VoltaicEngineering/Solar-Panel-Brackets/README.md

# Solar-Panel-Brackets
Bracket designs to mount Voltaic solar panels to a pole

We fabricate these panels and sell them to our customers, but if you would like to modify the design or fabricate locally, you are free to do so.
