VoltaicEngineering/Solar-Panel-Brackets/Large Panel Bracket Rev 3 BENT STEP.step

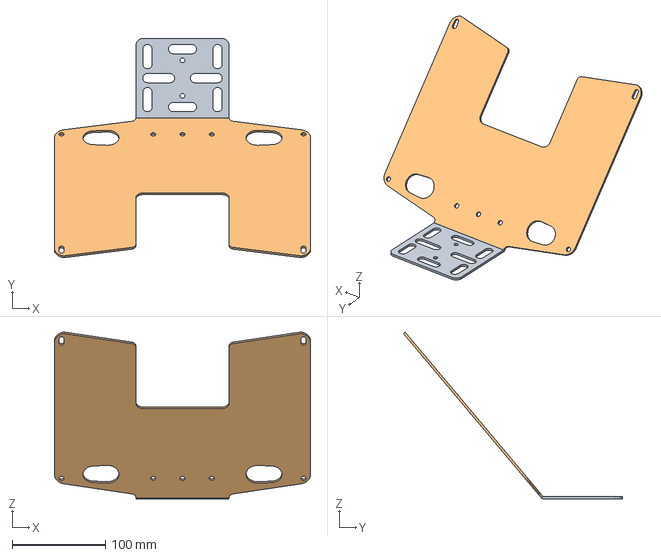
[picture p1: CAD file, 2018-04-16]
Large Panel Bracket Rev 3 BENT STEP.step
274.0 x 234.7 x 178.6 mm
Top Mounting
Panel Frame
