VoltaicEngineering/Solar-Panel-Brackets/Small Bracket Rev 4 BENT STEP.step

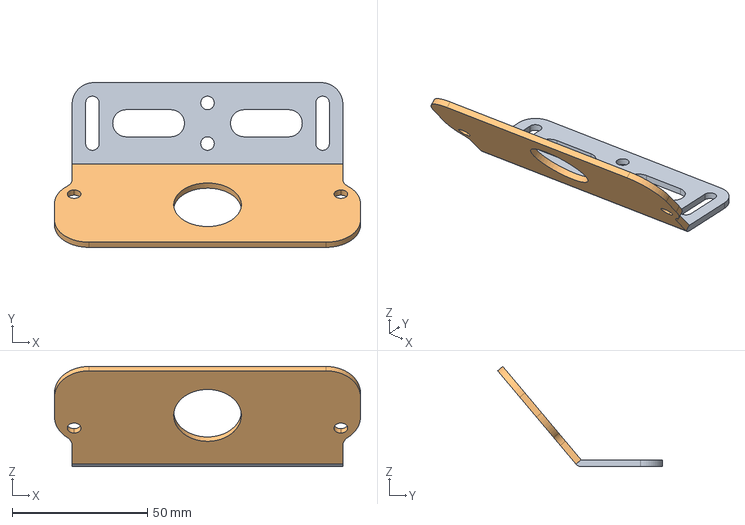
[picture p2: CAD file, 2018-04-16]
Small Bracket Rev 4 BENT STEP.step
113.0 x 60.8 x 37.0 mm
Top Mounting
Panel Section FLAT
