VoltaicEngineering/Solar-Panel-Brackets/Universal Panel Bracket Rev 6b BENT STEP.step

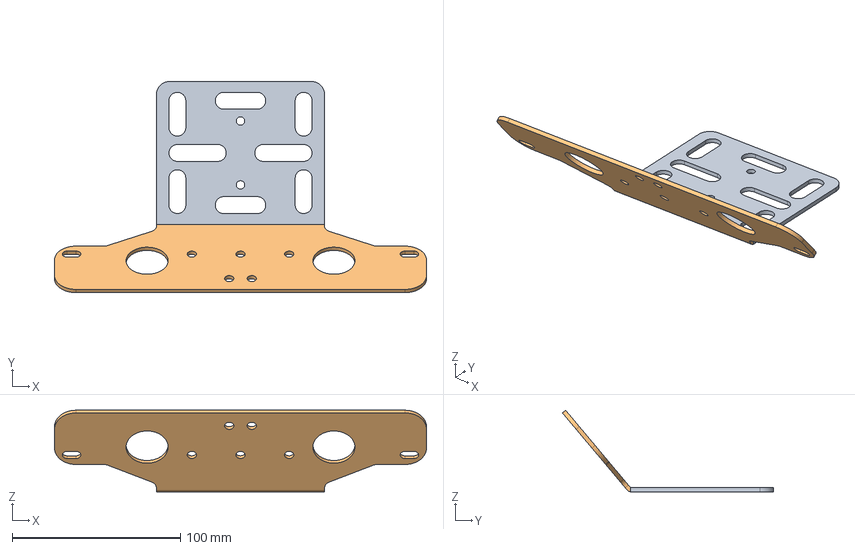
[picture p3: CAD file, 2018-04-16]
Universal Panel Bracket Rev 6b BENT STEP.step
221.0 x 125.5 x 48.5 mm
Top Mounting
Panel Frame
