VoltaicEngineering/Solar-Panel-Brackets/Universal Panel Bracket Rev 6b FLAT STEP.step

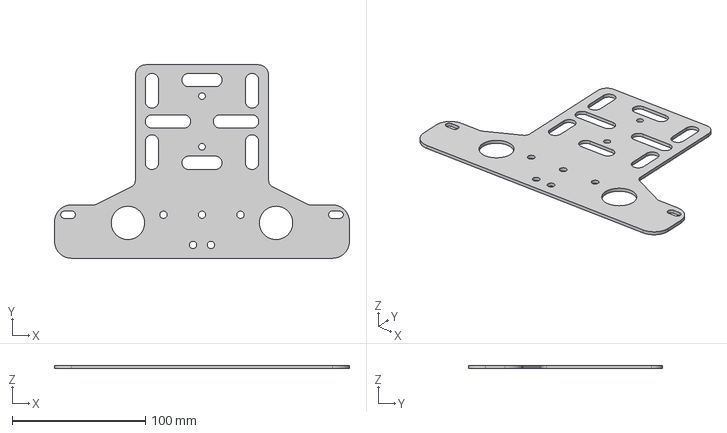
[picture p4: CAD file, 2018-04-05]
Universal Panel Bracket Rev 6b FLAT STEP.step
221.0 x 145.0 x 2.50 mm
