VoltaicEngineering/Solar-Panel-Brackets/Small Panel Bracket Rev 4 FLAT STEP.step

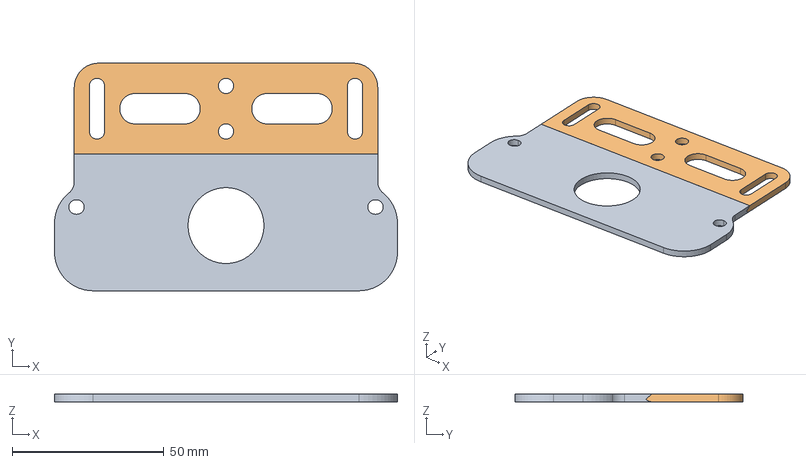
[picture p5: CAD file, 2018-04-05]
Small Panel Bracket Rev 4 FLAT STEP.step
113.0 x 75.0 x 2.50 mm
Panel Section FLAT
Top Mounting
