VoltaicEngineering/Solar-Panel-Brackets/Large Panel Bracket Rev 3 FLAT STEP.step

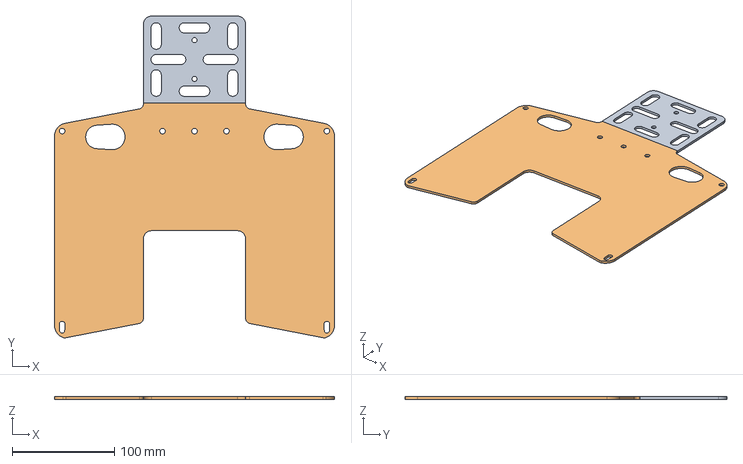
[picture p6: CAD file, 2018-04-05]
Large Panel Bracket Rev 3 FLAT STEP.step
274.0 x 314.9 x 2.50 mm
Top Mounting
Panel Frame
