VoltaicEngineering/Solar-Panel-Brackets/Large Panel Bracket Rev 3 DRAWING 2017 11 13.pdf

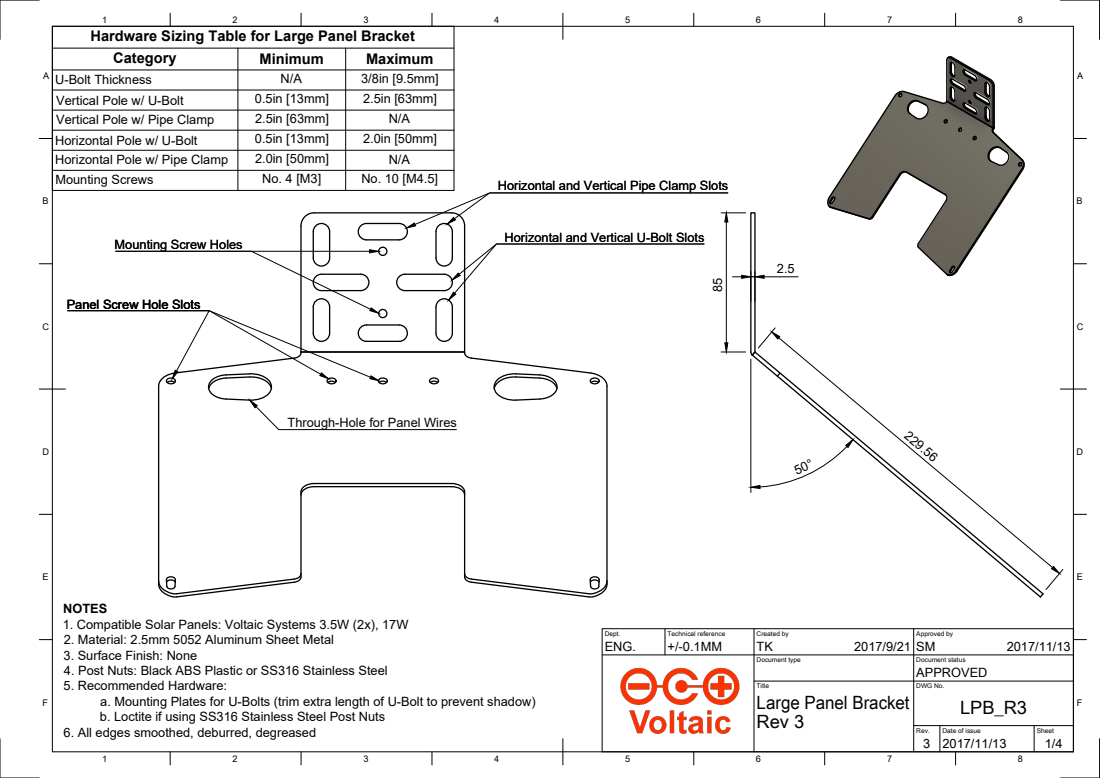
[picture p7: page 1]
Panel Screw Hole Slots

Hardware Sizing Table for Large Panel Bracket
Category | Minimum | Maximum

U-Bolt Thickness | N/A | 3/8in [9.5mm]
Vertical Pole w/ U-Bolt | 0.5in [13mm] | 2.5in [63mm]
Vertical Pole w/ Pipe Clamp | 2.5in [63mm] | N/A
Horizontal Pole w/ U-Bolt | 0.5in [13mm] | 2.0in [50mm]
Horizontal Pole w/ Pipe Clamp | 2.0in [50mm] | N/A
Mounting Screws | No. 4 [M3] | No. 10 [M4.5]

Horizontal and Vertical Pipe Clamp Slots

Horizontal and Vertical U-Bolt Slots

Mounting Screw Holes

Through-Hole for Panel Wires

NOTES
1. Compatible Solar Panels: Voltaic Systems 3.5W (2x), 17W
2. Material: 2.5mm 5052 Aluminum Sheet Metal
3. Surface Finish: None
4. Post Nuts: Black ABS Plastic or SS316 Stainless Steel
5. Recommended Hardware:

Dept. ENG. | Technical reference +/-0.1MM | Created by TK 2017/9/21 | Approved by SM 2017/11/13

Document type | Document status APPROVED

Title Rev 3 | DWG No. LPB_R3 Large Panel Bracket

a. Mounting Plates for U-Bolts (trim extra length of U-Bolt to prevent shadow)
b. Loctite if using SS316 Stainless Steel Post Nuts

6. All edges smoothed, deburred, degreased

Rev. 3 | Date of issue 2017/11/13 | Sheet

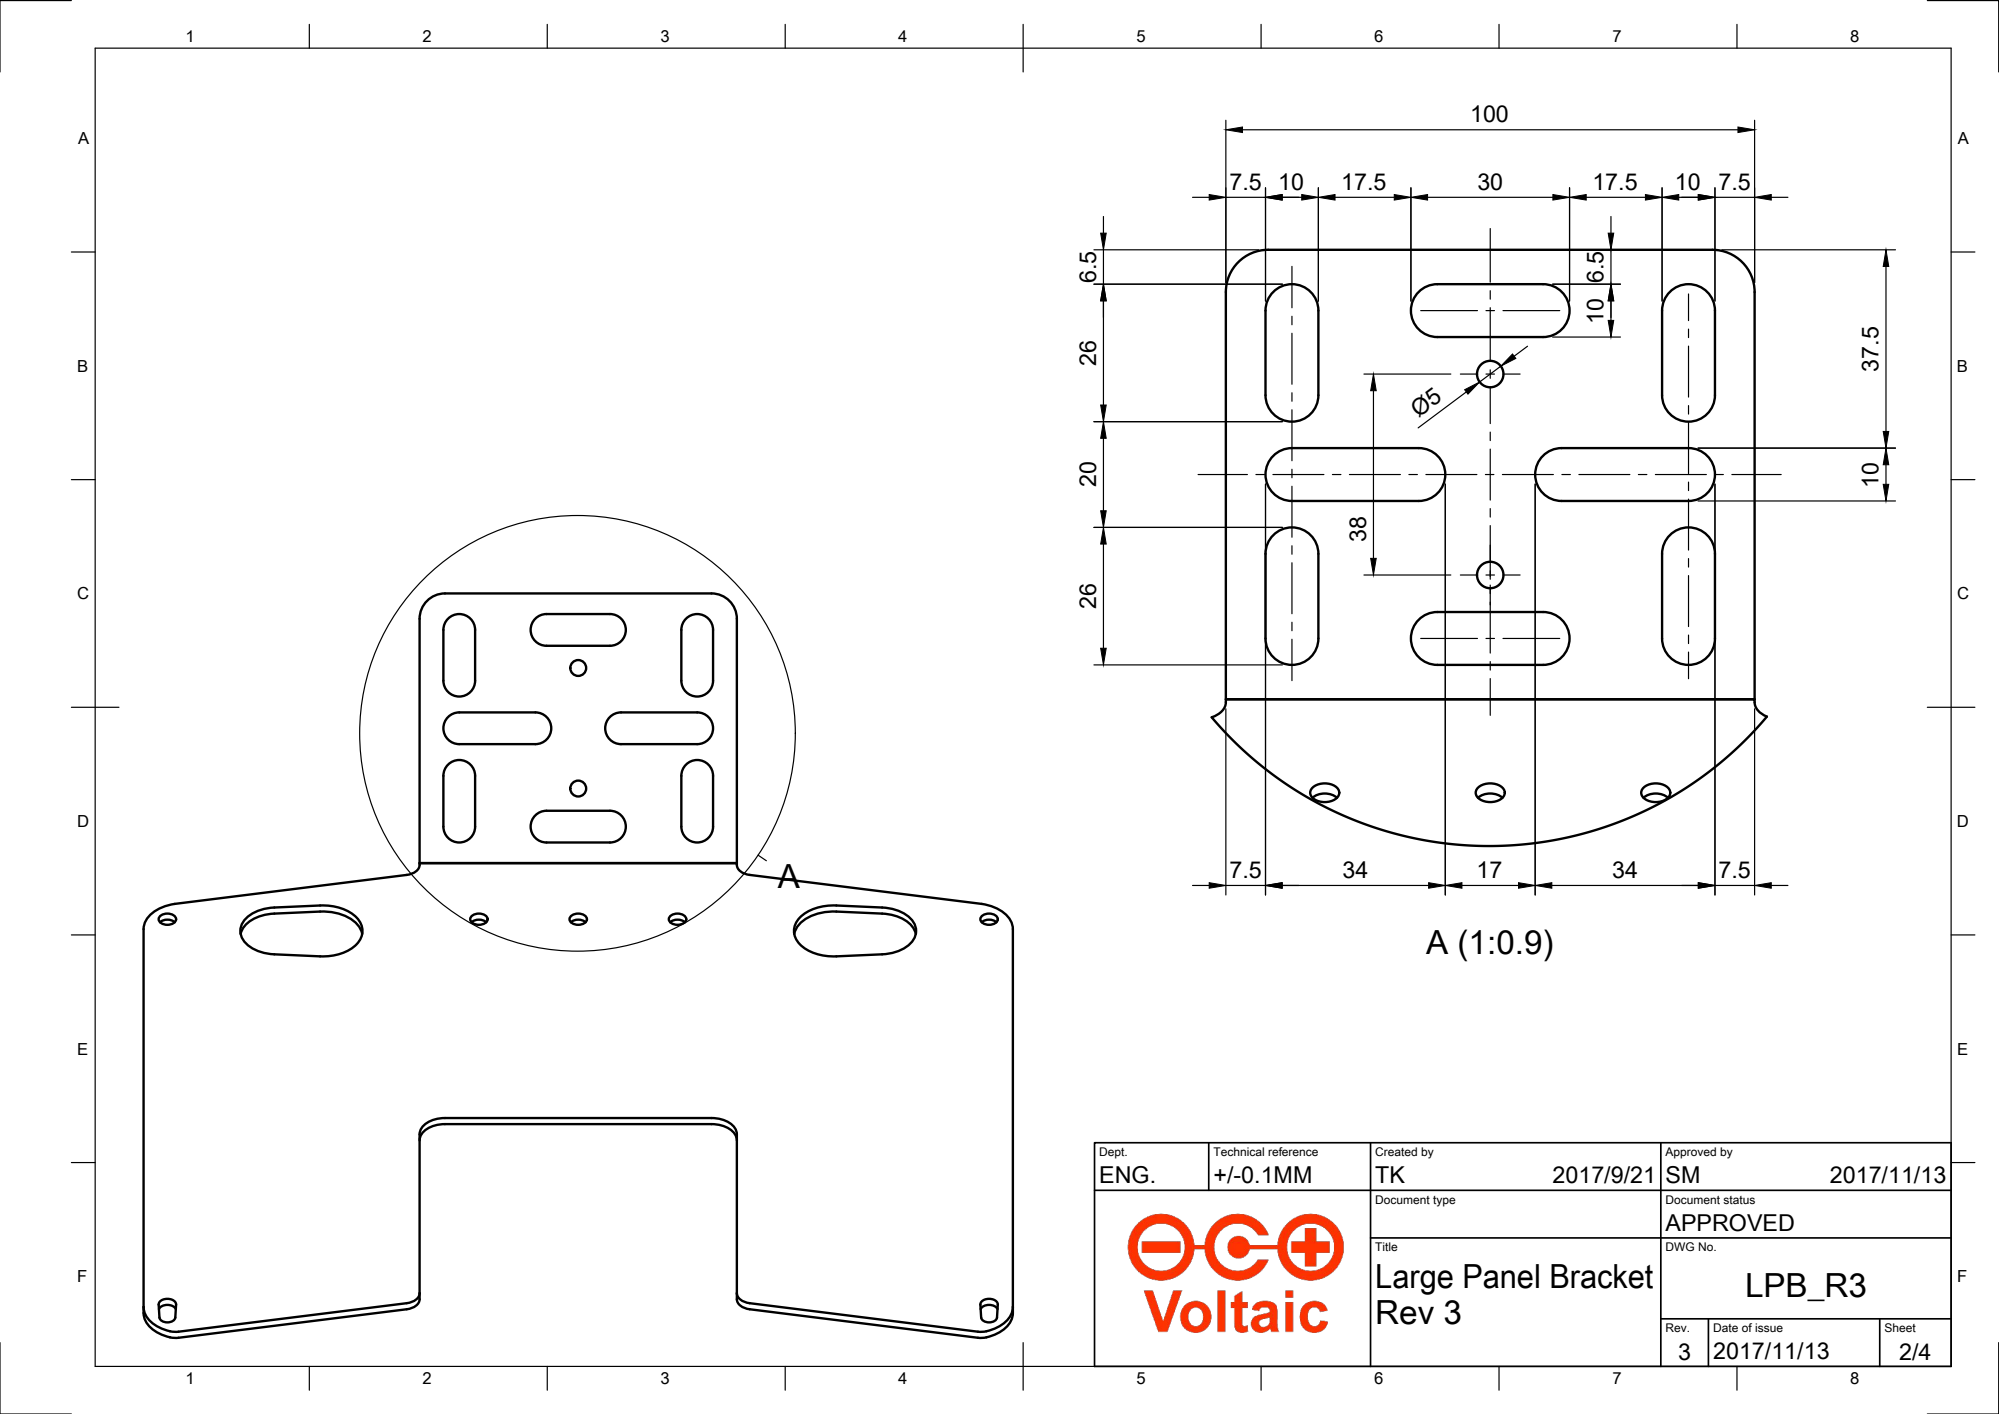
[picture p8: page 2]
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

Document type | Document status APPROVED

Title | DWG No. LPB_R3 Large Panel Bracket

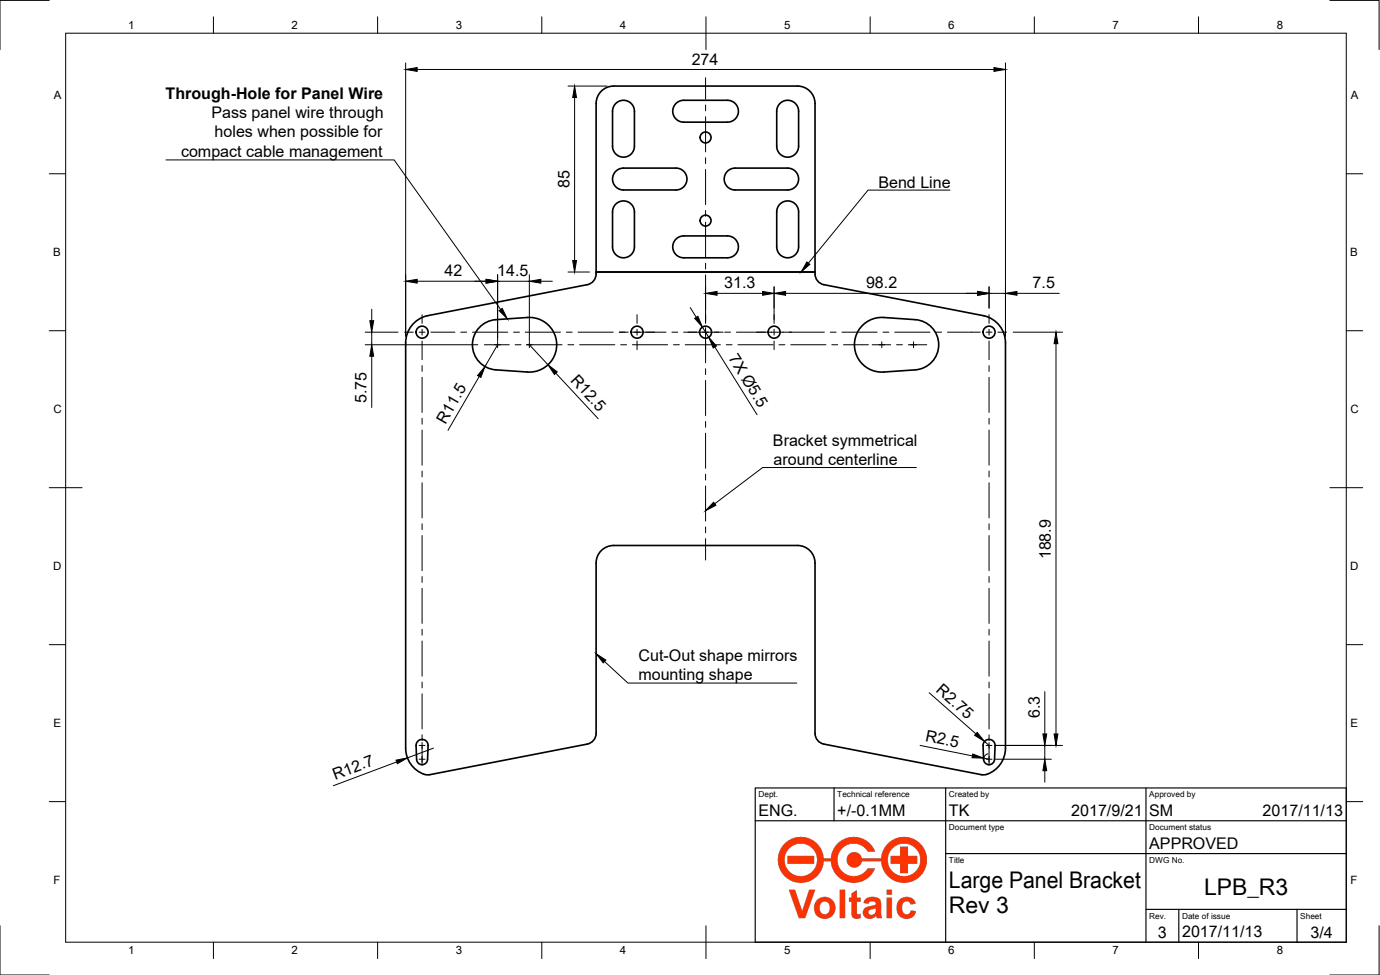
[picture p9: page 3]
Bend Line; Bracket symmetrical around centerline

Through-Hole for Panel Wire

Pass panel wire through
holes when possible for
compact cable management

Cut-Out shape mirrors
mounting shape

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

Document type | Document status APPROVED

Title | DWG No. LPB_R3 Large Panel Bracket

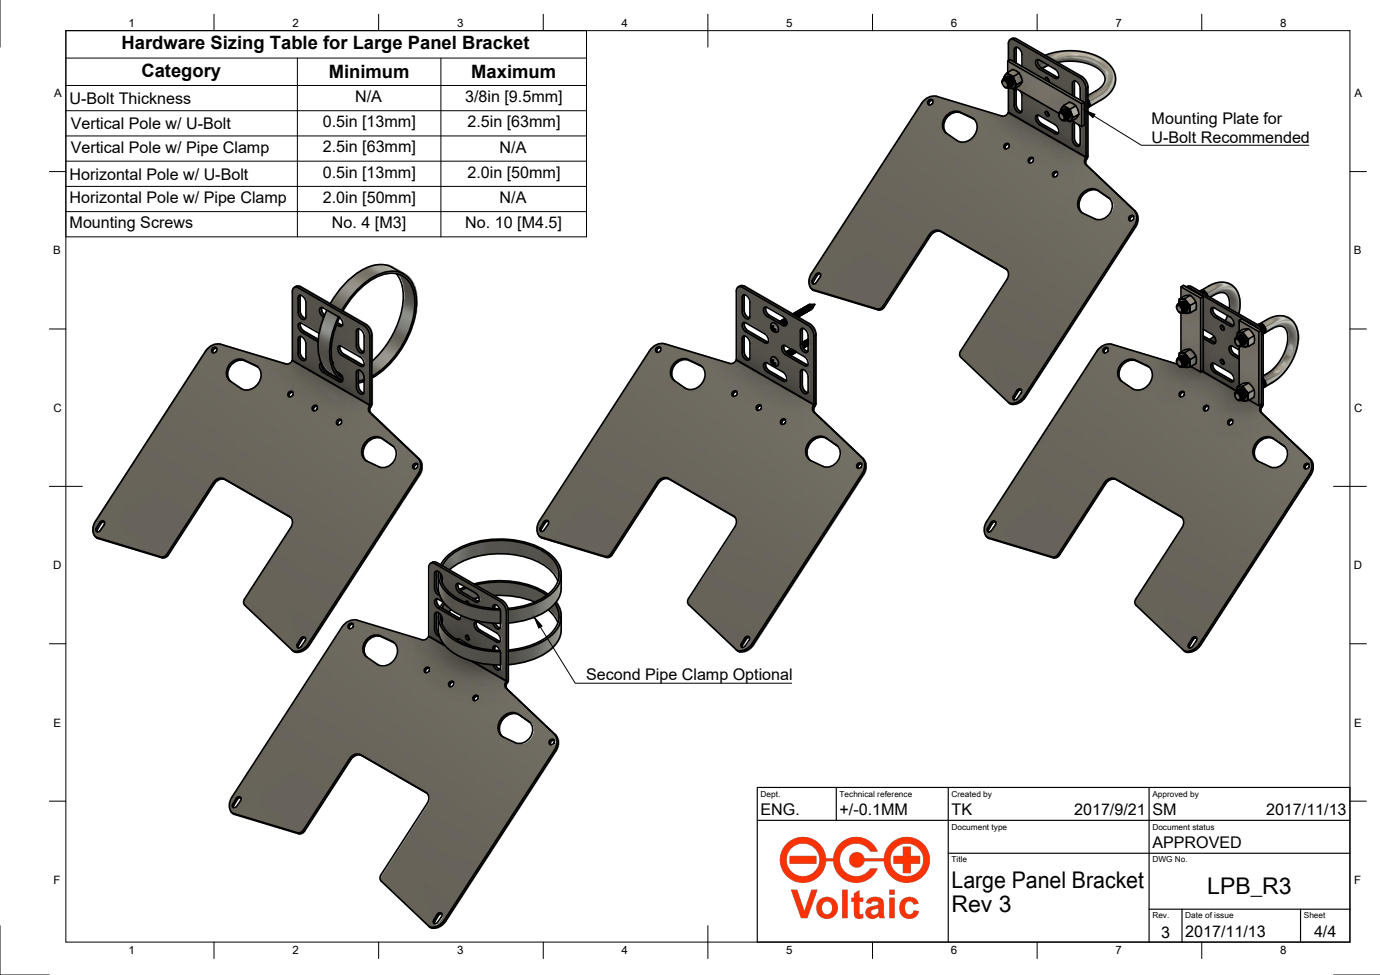
[picture p10: page 4]

Hardware Sizing Table for Large Panel Bracket
Category | Minimum | Maximum

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

Mounting Plate for
U-Bolt Recommended

Second Pipe Clamp Optional

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

Document type | Document status APPROVED

Title | DWG No. LPB_R3 Large Panel Bracket
