VoltaicEngineering/Solar-Panel-Brackets/Small Panel Bracket Rev 4 DRAWING 2017 9 13.pdf

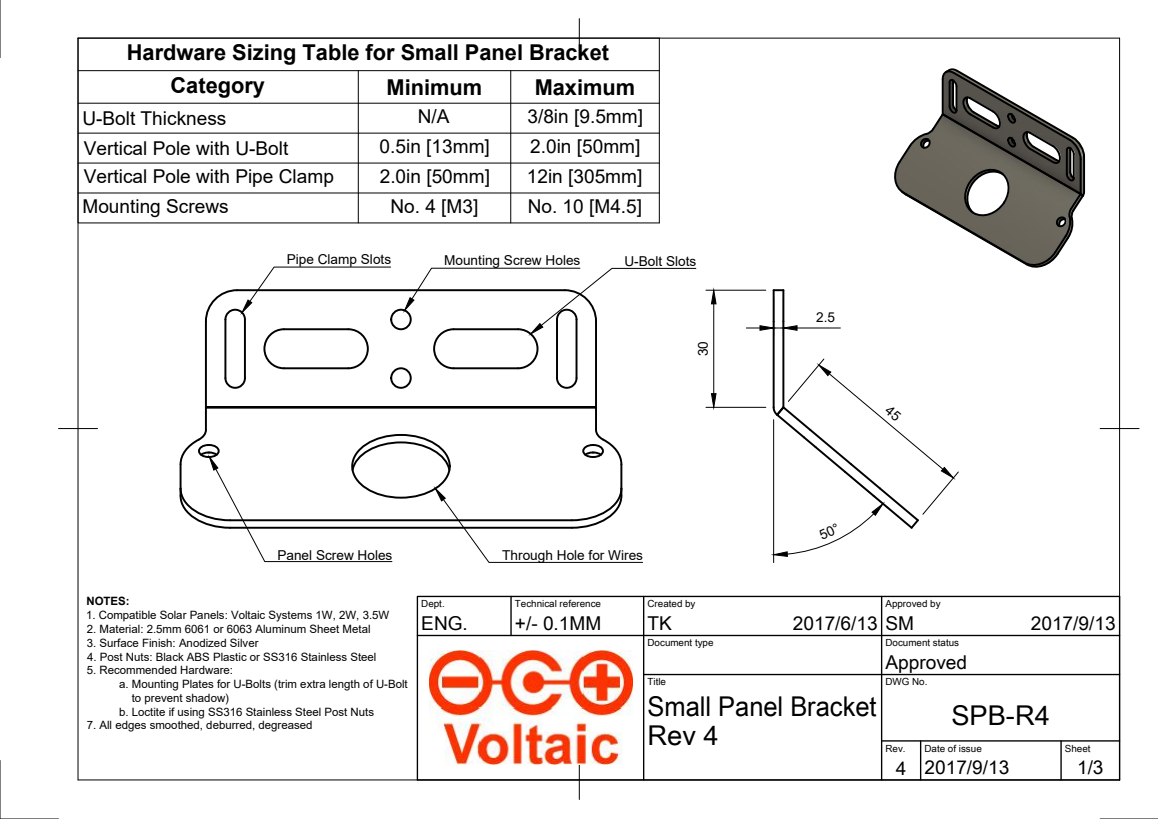
[picture p11: page 1]
ENG.; Pipe Clamp Slots; U-Bolt Slots

Hardware Sizing Table for Small Panel Bracket
Category | Minimum | Maximum

U-Bolt Thickness | N/A | 3/8in [9.5mm]
Vertical Pole with U-Bolt | 0.5in [13mm] | 2.0in [50mm]
Vertical Pole with Pipe Clamp | 2.0in [50mm] | 12in [305mm]
Mounting Screws | No. 4 [M3] | No. 10 [M4.5]

Mounting Screw Holes

Panel Screw Holes

Through Hole for Wires

NOTES:
1. Compatible Solar Panels: Voltaic Systems 1W, 2W, 3.5W
2. Material: 2.5mm 6061 or 6063 Aluminum Sheet Metal
3. Surface Finish: Anodized Silver
4. Post Nuts: Black ABS Plastic or SS316 Stainless Steel
5. Recommended Hardware:
a. Mounting Plates for U-Bolts (trim extra length of U-Bolt
to prevent shadow)
b. Loctite if using SS316 Stainless Steel Post Nuts
7. All edges smoothed, deburred, degreased

Dept. | Technical reference | Created by 2017/6/13 | Approved by 2017/9/13

Document type | Document status Approved

Title Rev 4 | DWG No. SPB-R4 Small Panel Bracket

Rev. 4 | Date of issue 2017/9/13 | Sheet

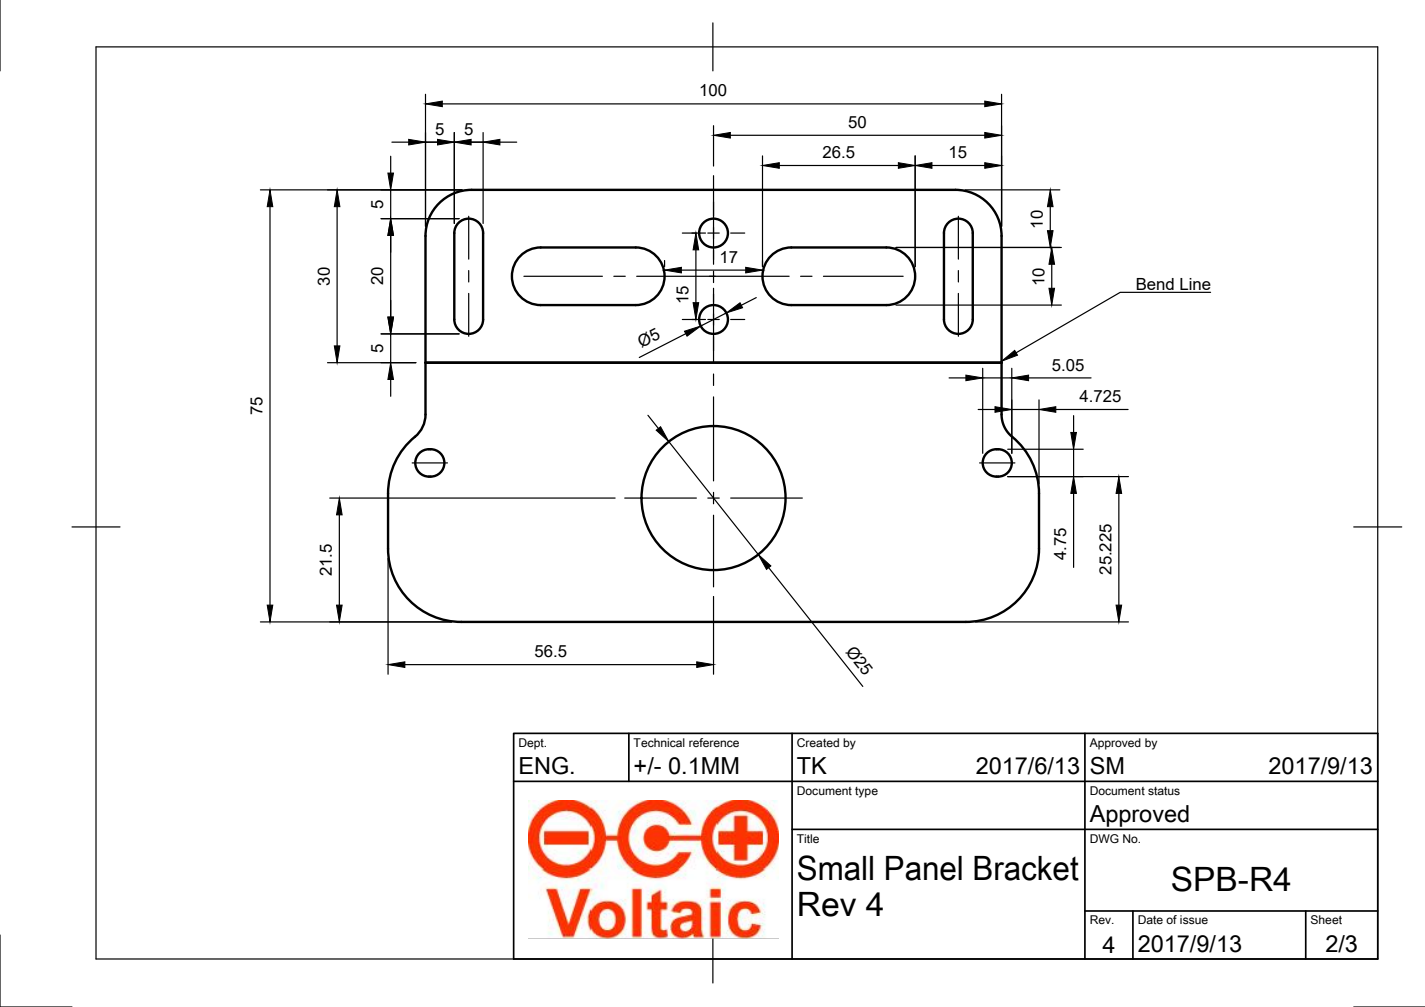
[picture p12: page 2]
Bend Line

Dept. ENG. | Technical reference +/- 0.1MM | Created by TK 2017/6/13 | Approved by SM 2017/9/13

Document type | Document status Approved

Title Rev 4 | DWG No. SPB-R4 Small Panel Bracket

Rev. | Date of issue | Sheet

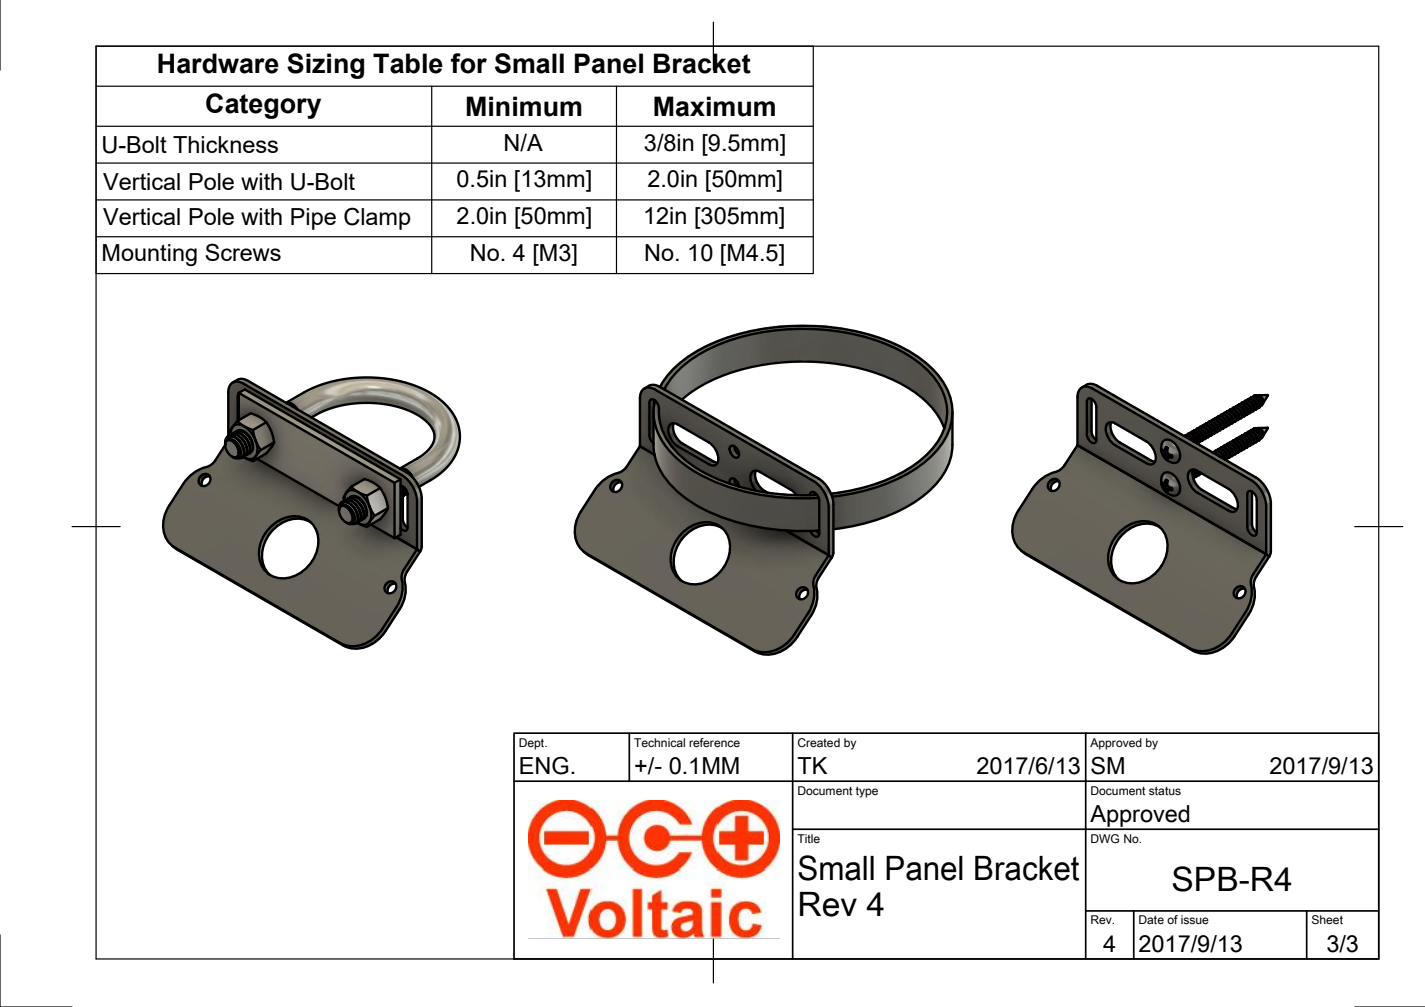
[picture p13: page 3]

Hardware Sizing Table for Small Panel Bracket
Category | Minimum | Maximum

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

Document type | Document status Approved

Title Rev 4 | DWG No. SPB-R4 Small Panel Bracket

Rev. | Date of issue | Sheet
