VoltaicEngineering/Solar-Panel-Brackets/Universal Panel Bracket Rev 6b DRAWING 2017 11 13.pdf

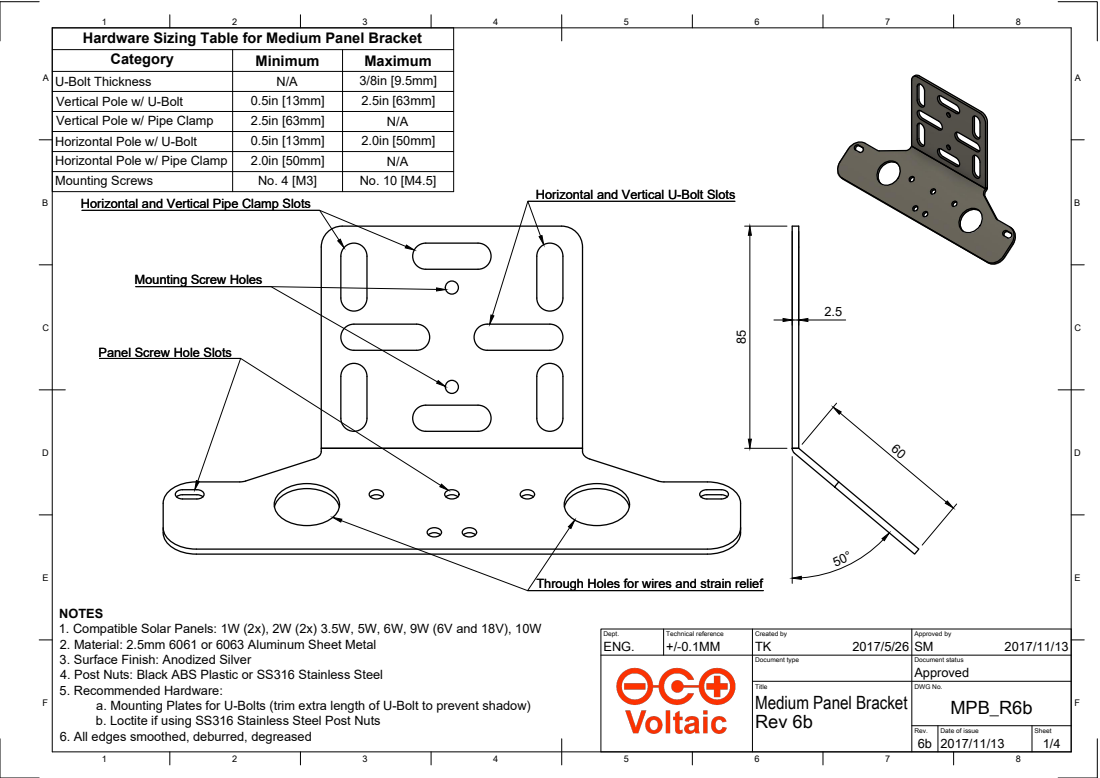
[picture p14: page 1]
Horizontal and Vertical Pipe Clamp Slots; Horizontal and Vertical U-Bolt Slots

Hardware Sizing Table for Medium Panel Bracket
Category | Minimum | Maximum

U-Bolt Thickness | N/A | 3/8in [9.5mm]
Vertical Pole w/ U-Bolt | 0.5in [13mm] | 2.5in [63mm]
Vertical Pole w/ Pipe Clamp | 2.5in [63mm] | N/A
Horizontal Pole w/ U-Bolt | 0.5in [13mm] | 2.0in [50mm]
Horizontal Pole w/ Pipe Clamp | 2.0in [50mm] | N/A
Mounting Screws | No. 4 [M3] | No. 10 [M4.5]

Horizontal and Vertical U-Bolt Slots Horizontal and Vertical Pipe Clamp Slots

Mounting Screw Holes

Panel Screw Hole Slots

Through Holes for wires and strain relief

NOTES
1. Compatible Solar Panels: 1W (2x), 2W (2x) 3.5W, 5W, 6W, 9W (6V and 18V), 10W
2. Material: 2.5mm 6061 or 6063 Aluminum Sheet Metal
3. Surface Finish: Anodized Silver
4. Post Nuts: Black ABS Plastic or SS316 Stainless Steel
5. Recommended Hardware:

Dept. ENG. | Technical reference +/-0.1MM | Created by TK 2017/5/26 | Approved by SM 2017/11/13

Document type | Document status Approved

Title Medium Panel Bracket Rev 6b | DWG No. MPB_R6b

a. Mounting Plates for U-Bolts (trim extra length of U-Bolt to prevent shadow)
b. Loctite if using SS316 Stainless Steel Post Nuts

6. All edges smoothed, deburred, degreased

Rev. 6b | Date of issue 2017/11/13 | Sheet

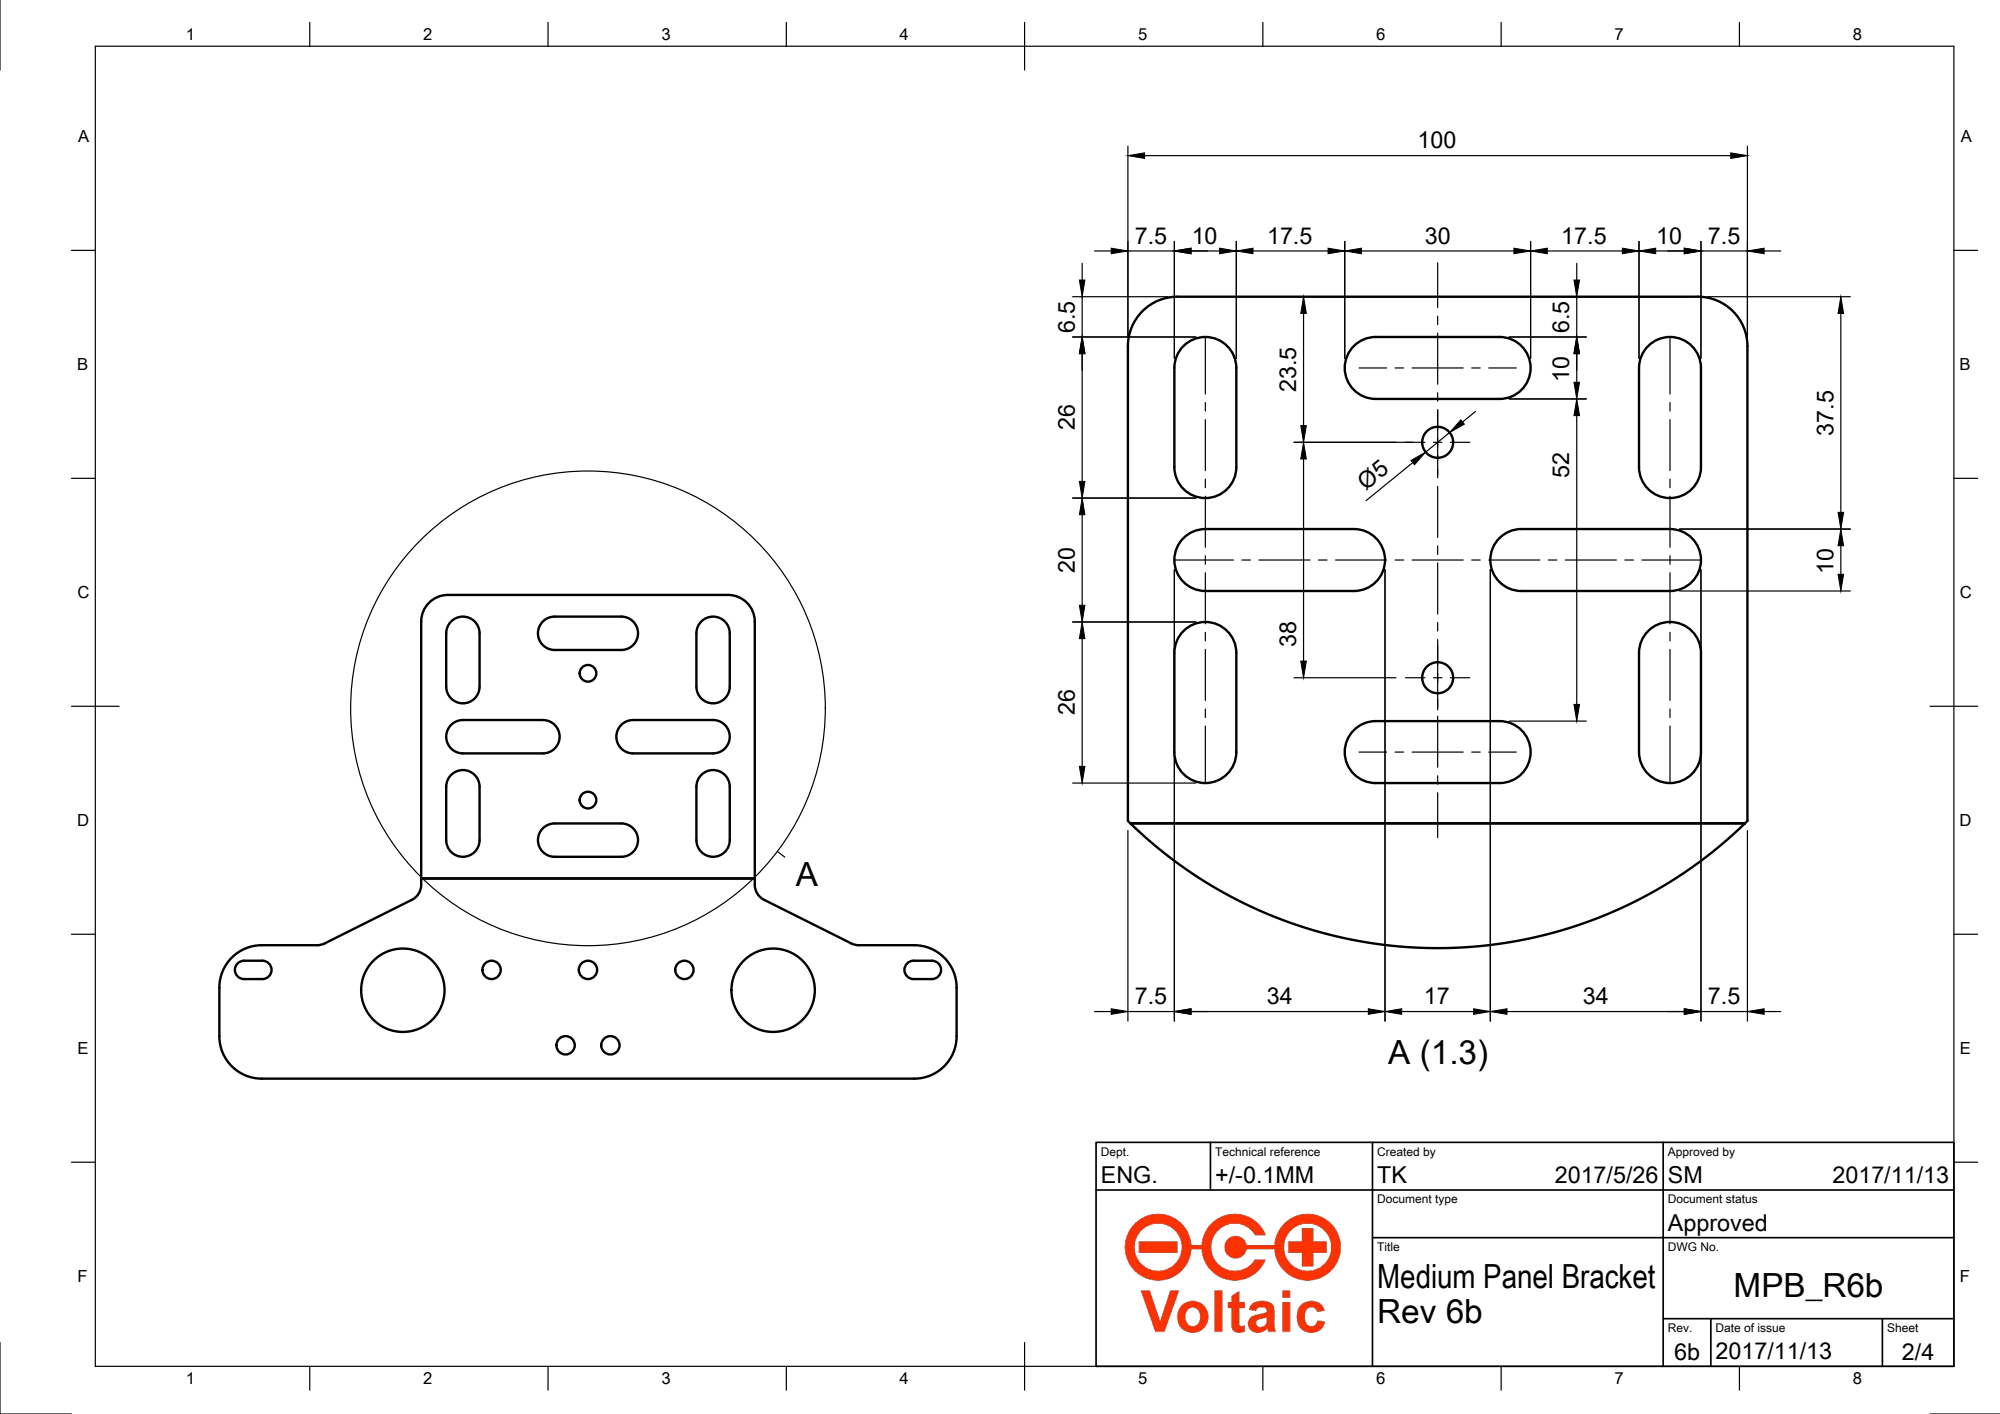
[picture p15: page 2]
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

Document type | Document status Approved

Title Medium Panel Bracket | DWG No. MPB_R6b

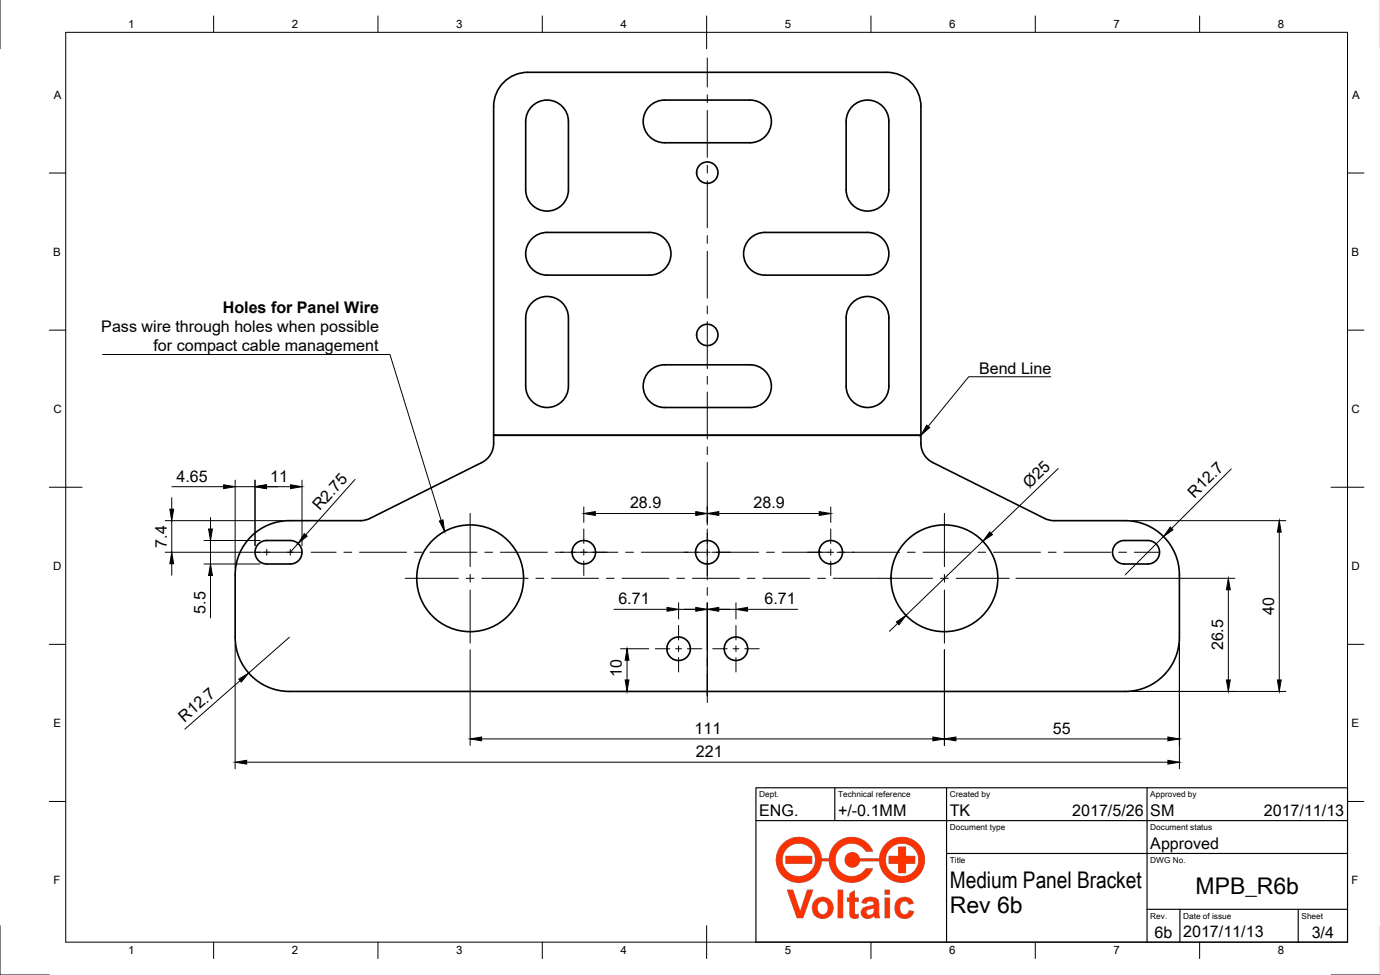
[picture p16: page 3]
Bend Line

Holes for Panel Wire

Pass wire through holes when possible

for compact cable management

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

Document type | Document status Approved

Title Medium Panel Bracket | DWG No. MPB_R6b

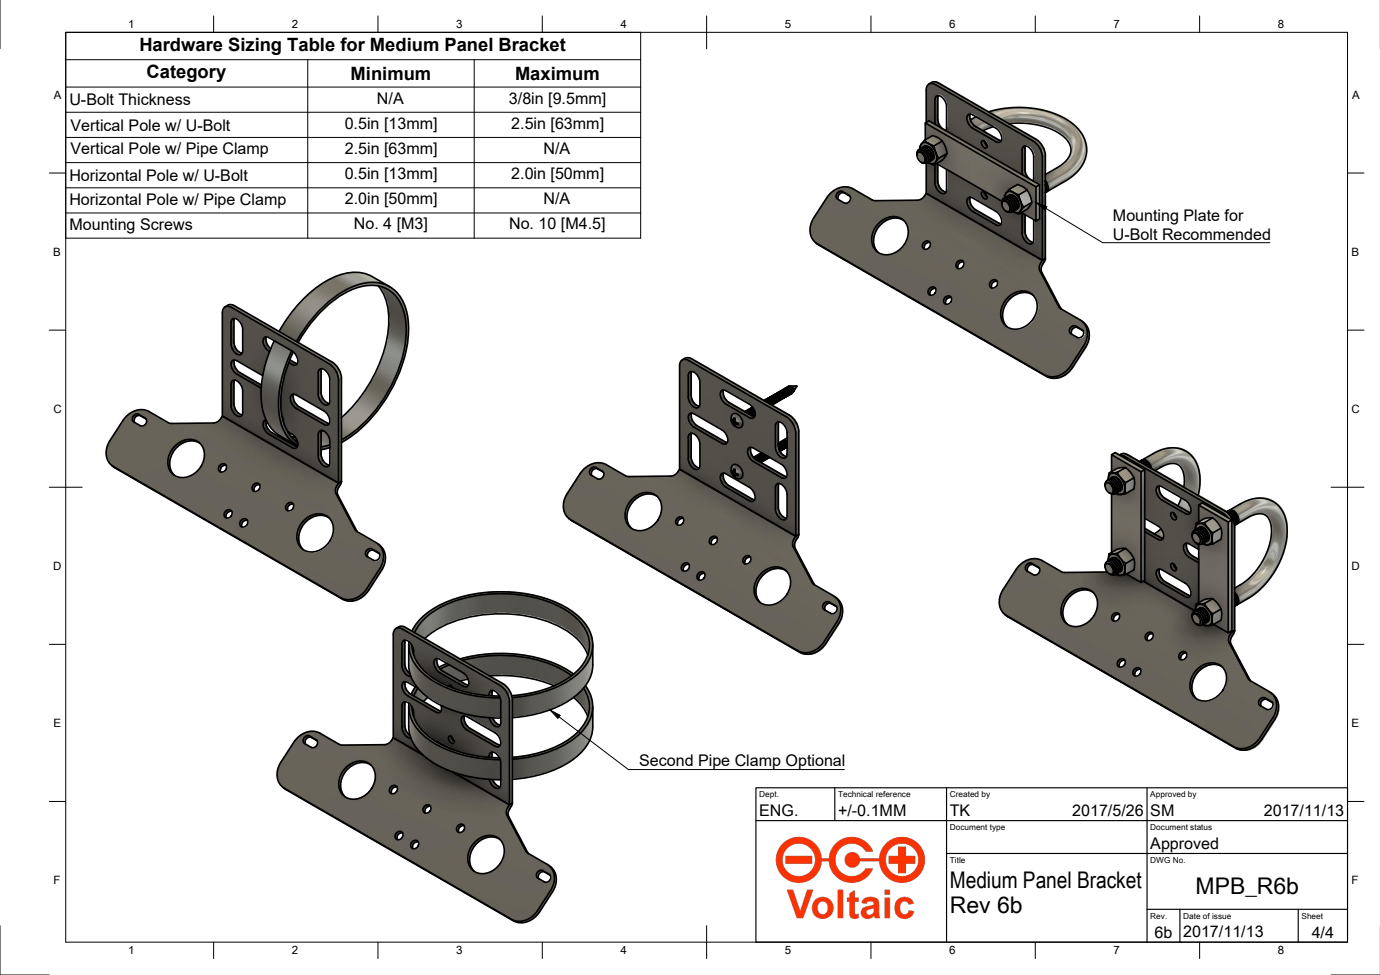
[picture p17: page 4]

Hardware Sizing Table for Medium Panel Bracket
Category | Minimum | Maximum

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

Mounting Plate for
U-Bolt Recommended

Second Pipe Clamp Optional

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

Document type | Document status Approved

Title Medium Panel Bracket | DWG No. MPB_R6b
