VoltaicEngineering/Solar-Panel-Brackets/(threads)

Thread 1 (2018-06-27):

Changing angle

fgnievinski, 2018-06-27:
If I need the bracket to have an angle different than 45 degrees at my location, would it be okay just to bend this bracket?

VoltaicEngineering, 2018-06-27:
yes, if you have a press brake or another tool to bend the bracket, you can bend it manually to adjust the angle.
